enny1170/MyWallSwitch/schematic/MyWallSwitch/pcb3d.png

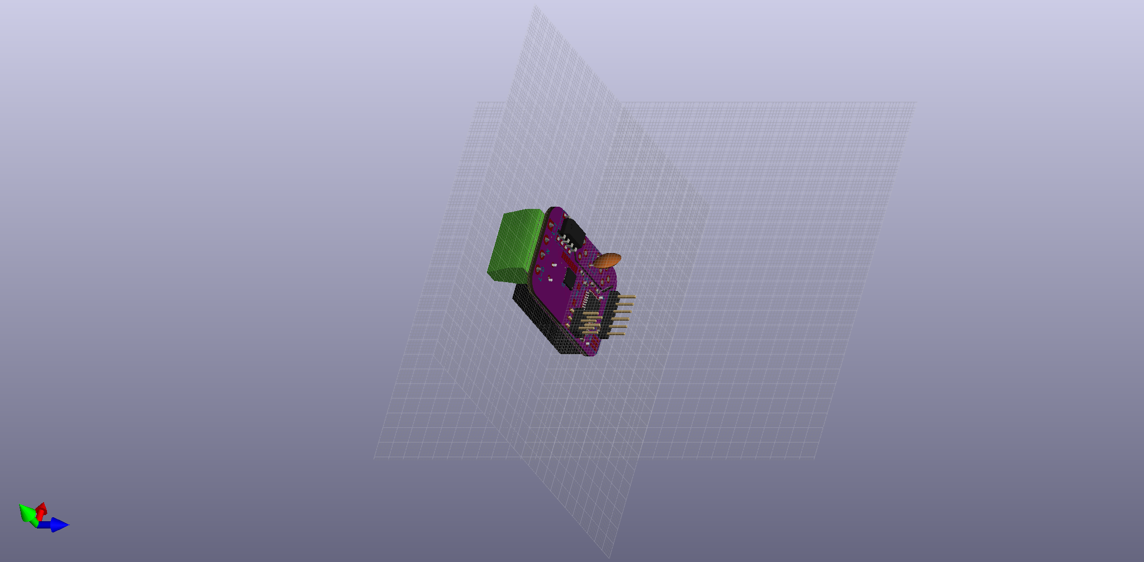
schematic/MyWallSwitch/pcb3d.png
