enny1170/MyWallSwitch/README.md

# MyWallSwitch
MySensors based Wall Switch EU
