enny1170/MyWallSwitch/enclosure/template_obj/WallSwitchAssembly2.stl

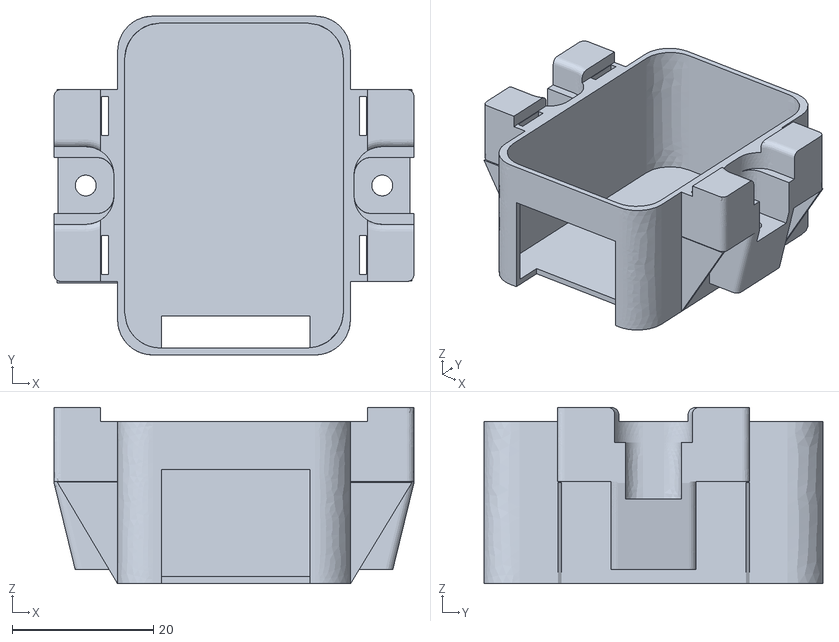
[picture p2: CAD file, 2019-05-06]
enclosure/template_obj/WallSwitchAssembly2.stl
51.0 x 48.0 x 25.0
