enny1170/MyWallSwitch/enclosure/template_obj/WallSwitchCaseBase.stl

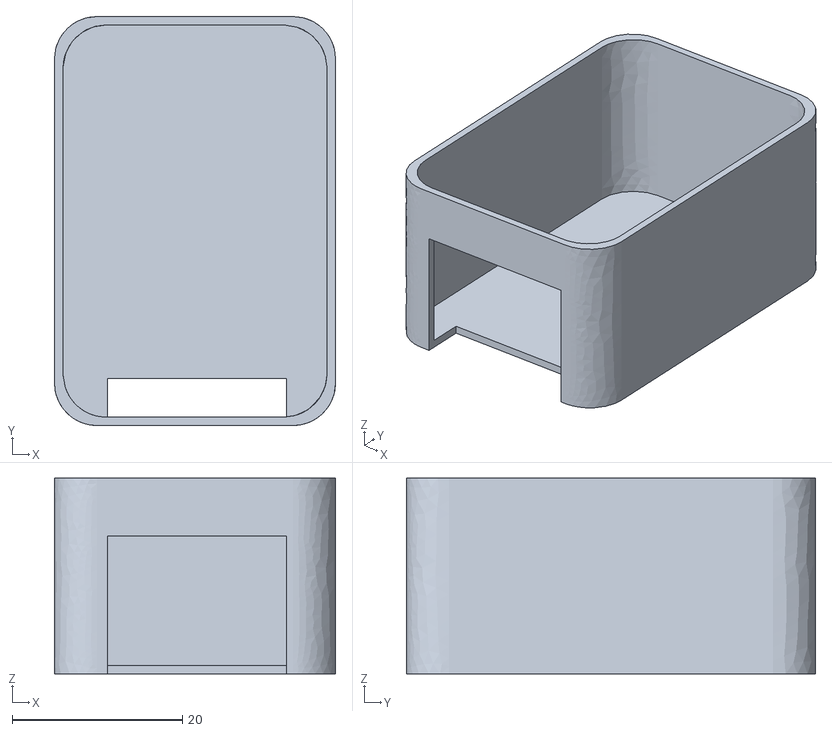
[picture p3: CAD file, 2019-05-06]
enclosure/template_obj/WallSwitchCaseBase.stl
33.0 x 48.0 x 23.0
