enny1170/MyWallSwitch/enclosure/template_obj/WallSwitchHolder.stl

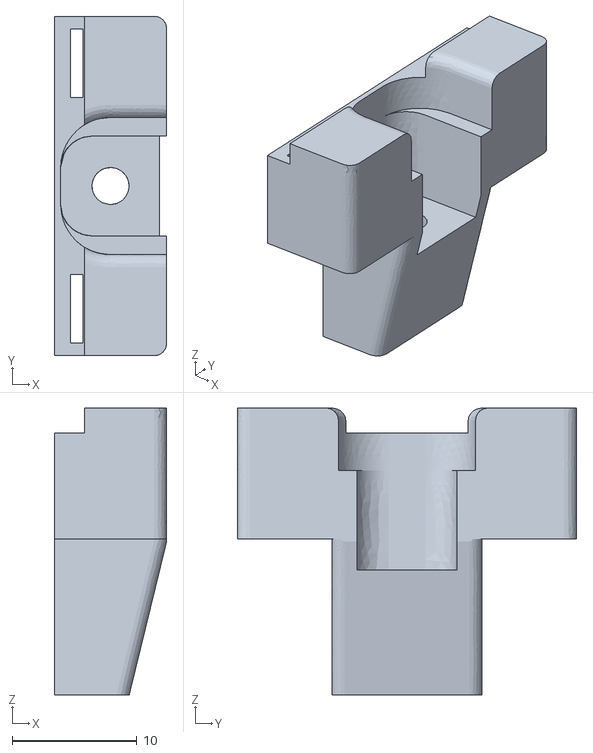
[picture p4: CAD file, 2019-05-06]
enclosure/template_obj/WallSwitchHolder.stl
9.00 x 27.2 x 23.0
