enny1170/MyWallSwitch/enclosure/template_obj/WallSwitchTop.stl

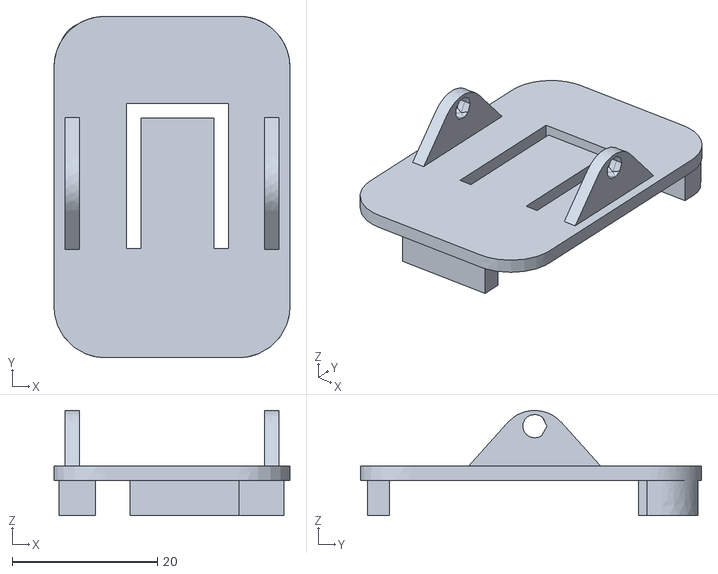
[picture p5: CAD file, 2019-05-03]
enclosure/template_obj/WallSwitchTop.stl
32.5 x 47.0 x 14.5
