enny1170/MyWallSwitch/enclosure/template_obj/WallSwitchToggle.stl

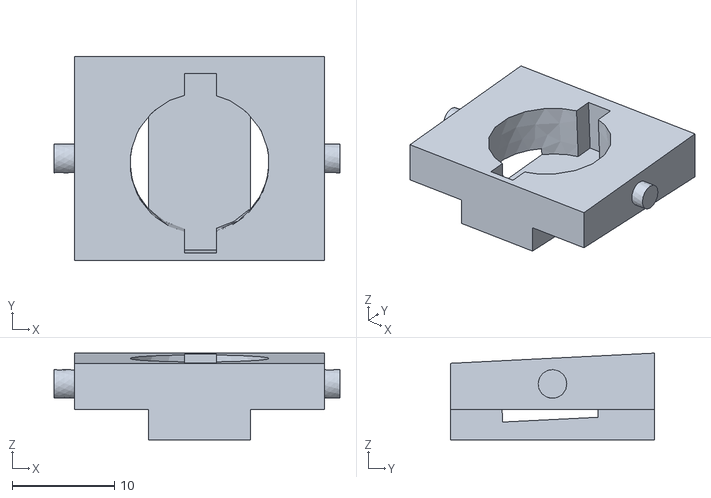
[picture p6: CAD file, 2019-05-03]
enclosure/template_obj/WallSwitchToggle.stl
28.0 x 20.0 x 8.50
