enny1170/MyWallSwitch/(list of files, cad)

Other CAD files:
enclosure/gira_55/WallSwitchBootomGira_v2.stl
