enny1170/MyWallSwitch/schematic/Schematic_v1.pdf

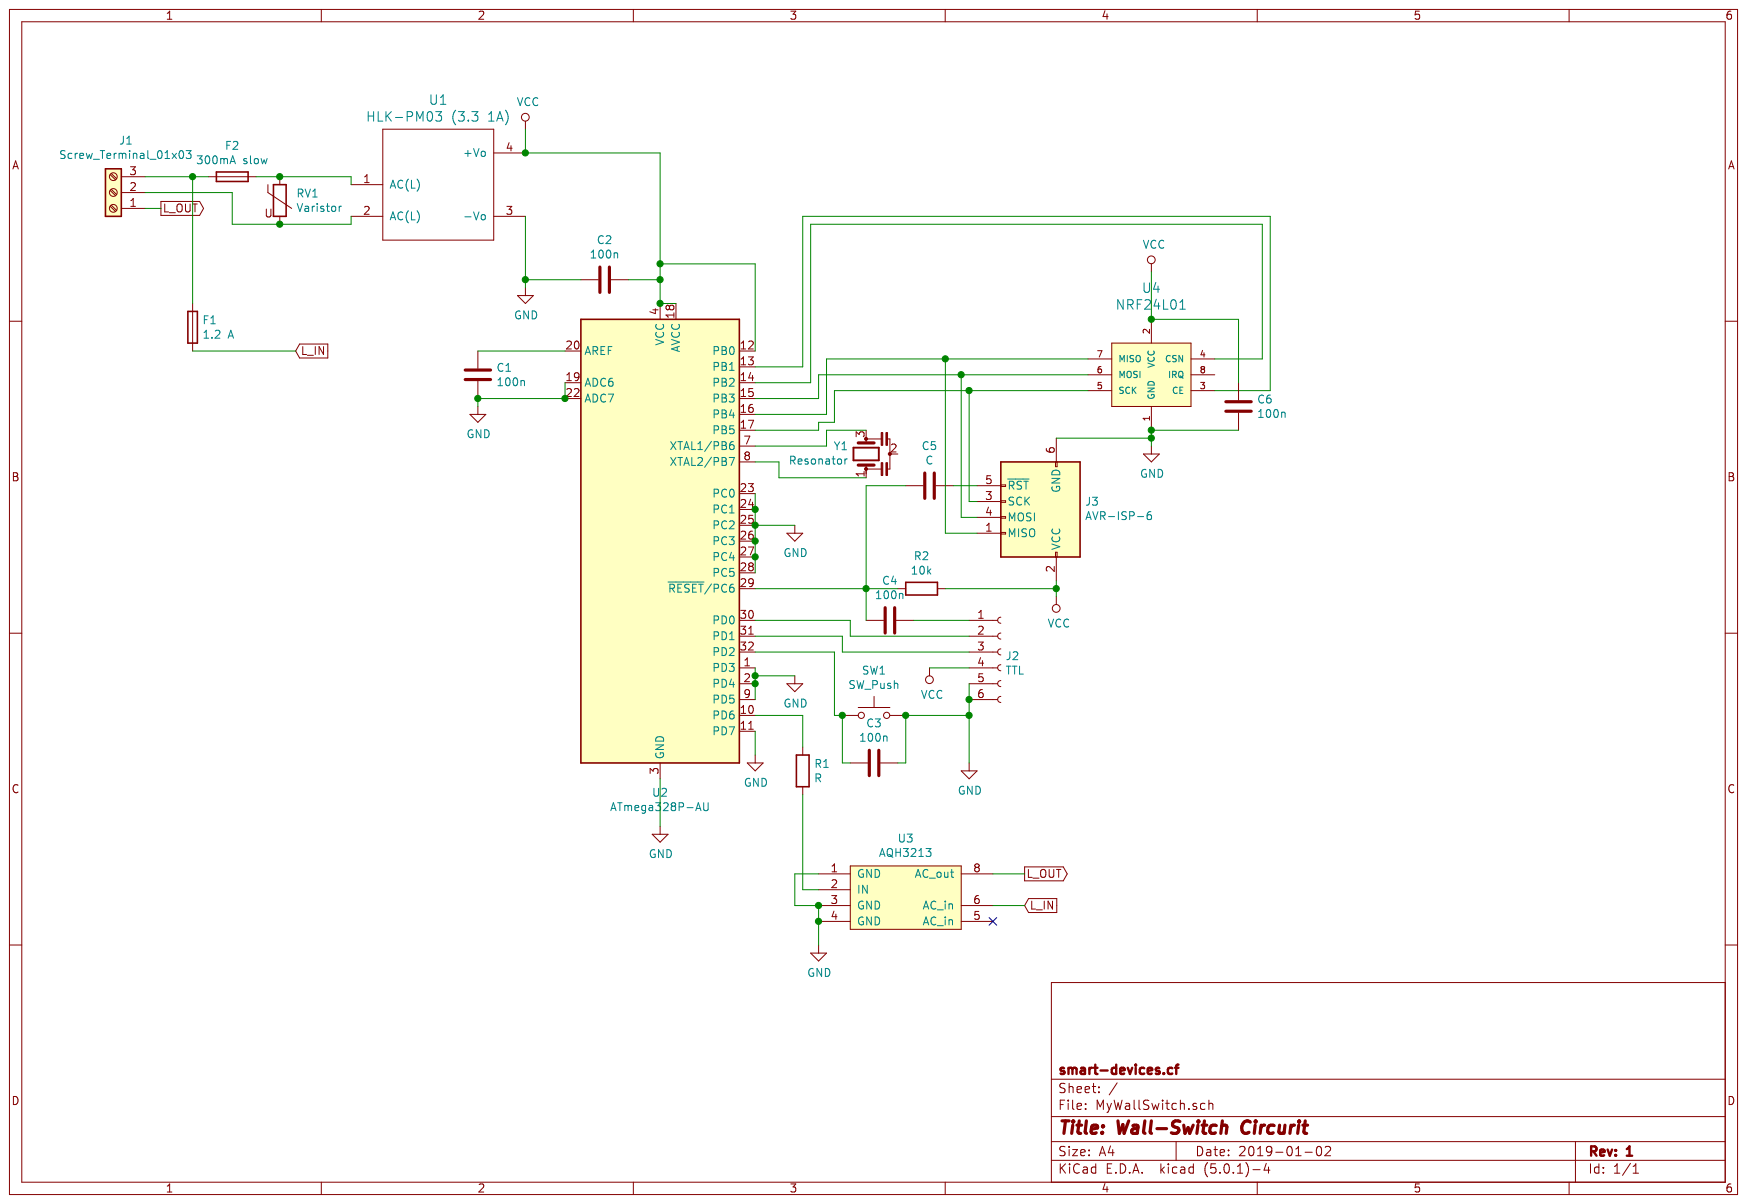
[picture p7: page 1]
