enny1170/MyWallSwitch/schematic/MyWallSwitch/PCB_V2/Schematic_v2.pdf

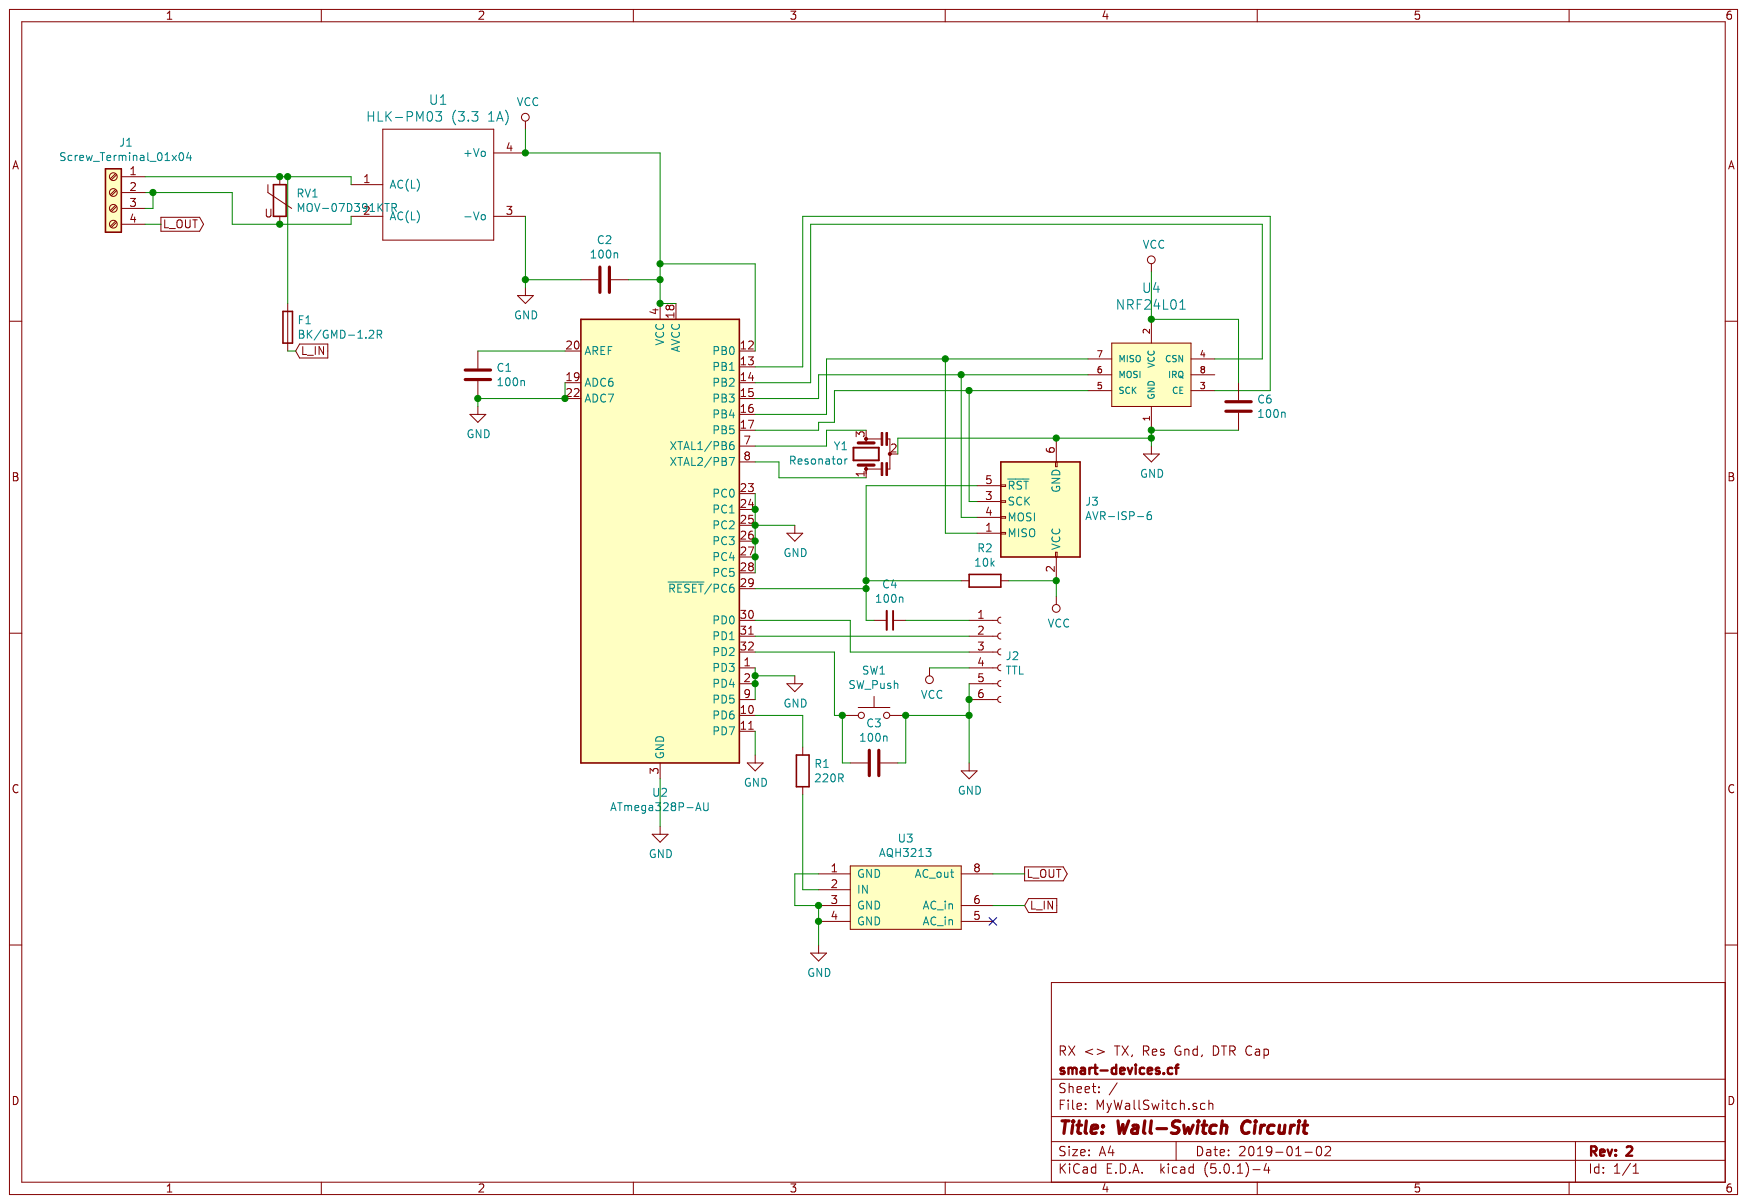
[picture p8: page 1]
