enny1170/MyWallSwitch/(list of files, drawings)

Other design files:
schematic/MyWallSwitch/MyWallSwitch.dsn
schematic/MyWallSwitch/MyWallSwitch_1.dsn
