enny1170/MyWallSwitch/schematic/MyWallSwitch/MyWallSwitch.kicad_pcb

## KiCad design schematic/MyWallSwitch/MyWallSwitch.kicad_pcb (2019-04-29)

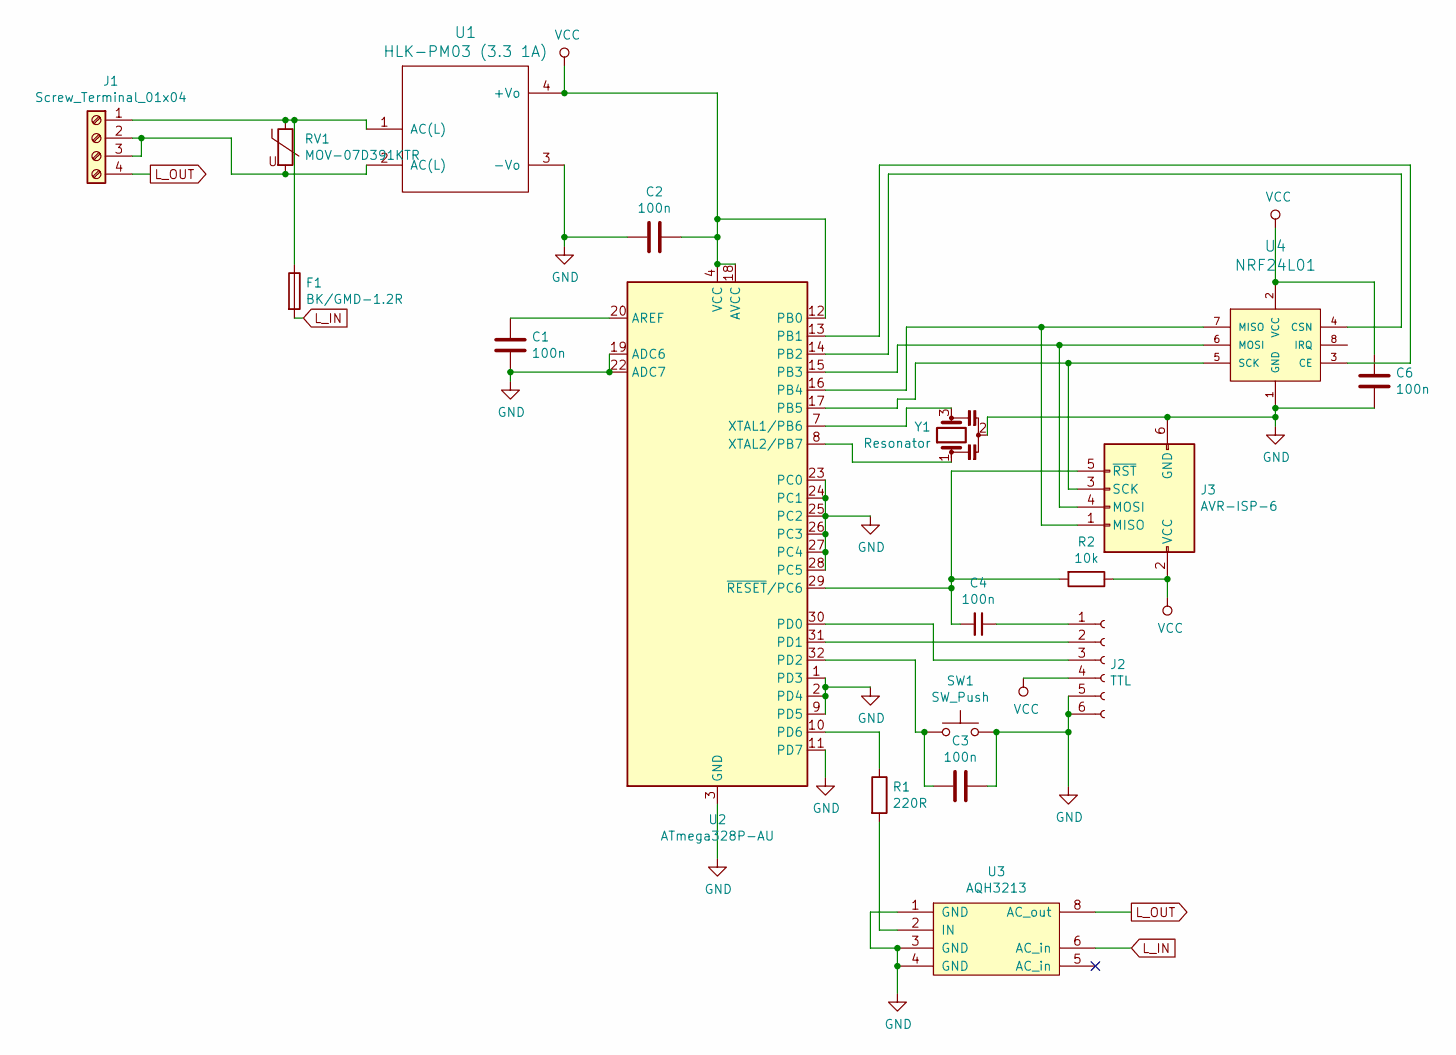
[picture p9: schematic MyWallSwitch.sch, Wall-Switch Circurit]

Parts:
C1, C2, C3, C4, C6: 100n; C_0603_HandSoldering
F1: BK/GMD-1.2R; Fuseholder5x20_horiz_open_universal_Type-III
J1: Screw_Terminal_01x04; TerminalBlock_bornier-4_P5.08mm
J2: TTL; Pin_Header_Straight_1x06_Pitch2.54mm
J3: AVR-ISP-6; Pin_Header_Straight_2x03_Pitch2.54mm_SMD
R1: 220R; R_0603_HandSoldering
R2: 10k; R_0603_HandSoldering
RV1: MOV-07D391KTR; RV_Disc_D7_W5.5_P5
SW1: SW_Push; SW_SPST_EVQPE1
U1: HLK-PM03 (3.3 1A); HLK-PM01
U2: ATmega328P-AU; TQFP-32_7x7mm_Pitch0.8mm
U3: AQH3213; DIP-8_W7.62mm_SMDSocket_SmallPads
U4: NRF24L01; NRF24L01-SMD
Y1: Resonator; Resonator_Ceramic

Connections:
GND: C1.2, C2.2, C3.1, C6.2, J2.5, J2.6, J3.6 (GND), SW1.2, U1.3 (-Vo), U2.1 (PD3), U2.2 (PD4), U2.3 (GND), U2.5 (GND), U2.9 (PD5), U2.11 (PD7), U2.19 (ADC6), U2.21 (GND), U2.22 (ADC7), U2.23 (PC0), U2.24 (PC1), U2.25 (PC2), U2.26 (PC3), U2.27 (PC4), U2.28 (PC5), U3.1 (GND), U3.3 (GND), U3.4 (GND), U4.1 (GND), Y1.2
L_IN: F1.2, U3.6 (AC_in)
L_OUT: J1.4, U3.8 (AC_out)
unnamed: C1.1, U2.20 (AREF)
unnamed: C3.2, SW1.1, U2.32 (PD2)
unnamed: C4.1, J2.1
unnamed: C4.2, J3.5 (~RST), R2.2, U2.29 (~RESET~/PC6)
unnamed: F1.1, J1.1, RV1.1, U1.1 (AC(L))
unnamed: J1.2, J1.3, RV1.2, U1.2 (AC(L))
unnamed: J2.2, U2.31 (PD1)
unnamed: J2.3, U2.30 (PD0)
unnamed: J3.1 (MISO), U2.16 (PB4), U4.7 (MISO)
unnamed: J3.3 (SCK), U2.17 (PB5), U4.5 (SCK)
unnamed: J3.4 (MOSI), U2.15 (PB3), U4.6 (MOSI)
unnamed: R1.1, U2.10 (PD6)
unnamed: R1.2, U3.2 (IN)
unnamed: U2.7 (XTAL1/PB6), Y1.3
unnamed: U2.8 (XTAL2/PB7), Y1.1
unnamed: U2.13 (PB1), U4.3 (CE)
unnamed: U2.14 (PB2), U4.4 (CSN)
VCC: C2.1, C6.1, J2.4, J3.2 (VCC), R2.1, U1.4 (+Vo), U2.4 (VCC), U2.6 (VCC), U2.12 (PB0), U2.18 (AVCC), U4.2 (VCC)

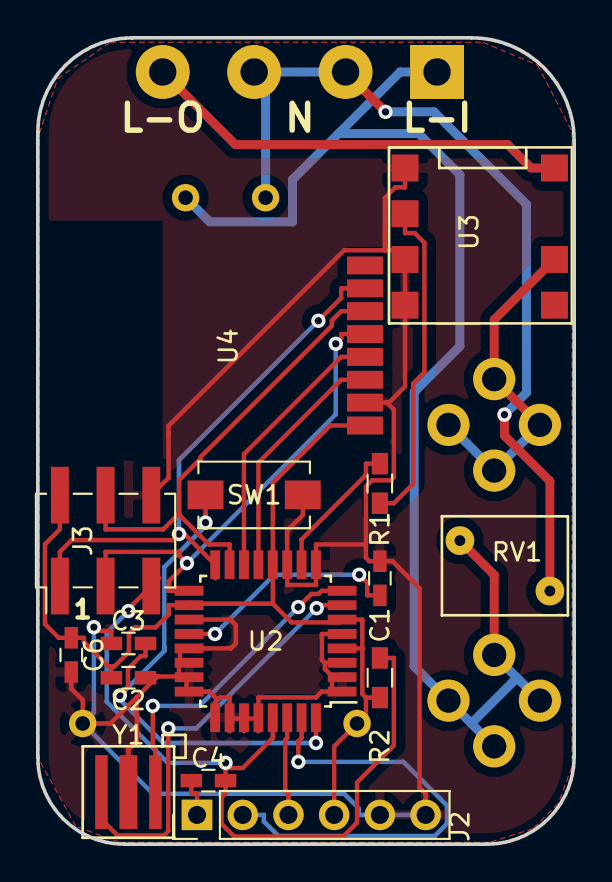
[picture p10: board MyWallSwitch.kicad_pcb from above]

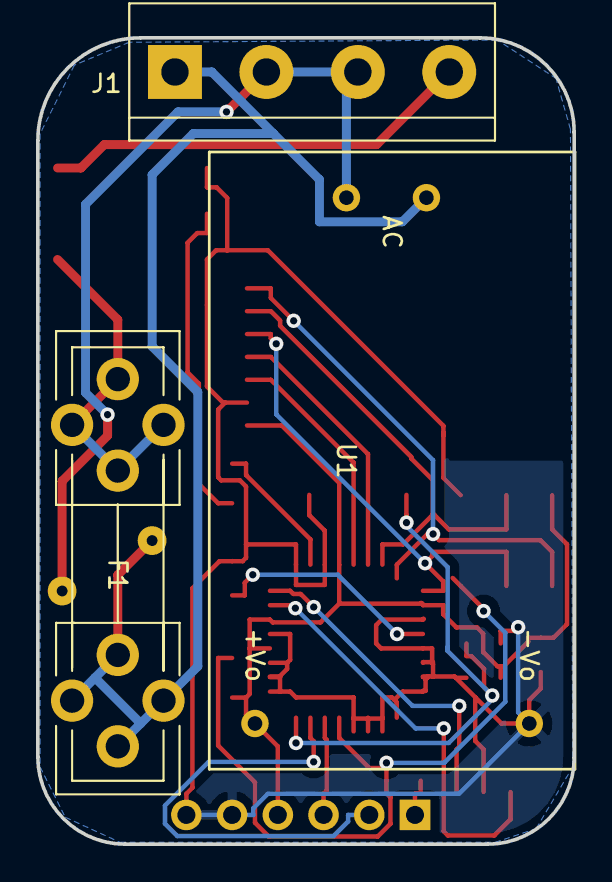
[picture p11: board MyWallSwitch.kicad_pcb from below]

Board: 2 copper layers, 29.8 x 44.8 mm, 18 parts (3 on the bottom side), 21 nets.
