enny1170/MyWallSwitch/(commit log)

2019-01-02 working Version
    [ConfigurationRequest.h, includes.cfg, style.cfg, suppressions.cfg]
2019-01-03 schematic added
    [MyWallSwitch.kicad_pcb, MyWallSwitch.sch]
2019-04-23 firmware build
    [BOM_MyWallSwitch_pcbWay.xlsx, ConfigurationRequest.h, Kopie von UPDATE w159926ash4-10sets-bom_mywallswitch_pcbway 2019-2-14.xlsx, Kopie von W159926ASH4-10sets-BOM_MyWallSwitch_pcbWay 2019-2-11.xlsx, Kopie von update W159926ASH4-10sets-BOM_MyWallSwitch_pcbWay 2019-2-13.xlsx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]
2019-04-29 Fix Shematic and PCB
    [BOM_MyWallSwitch_pcbWay.xlsx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]
2019-05-03 Sensor signal removed, repeater added V1.1
2019-05-06 enclosure objects added
    [WallSwitchAssembly2.stl, WallSwitchCaseBase.stl, WallSwitchHolder.stl, WallSwitchToggle.stl, WallSwitchTop.stl]
